KuruczKende/OmniPin/README.md

# OmniPin

## Description
This is a badge that can be customized while worn. The project contructs from a mobile application and a device.

### Technical Details
Microcontroller used: ESP32-C3-Mini-1
E-Paper: GDEM0154F51H
