KuruczKende/OmniPin/DeviceHardware/OmniPin/OmniPin.kicad_pcb

## KiCad design DeviceHardware/OmniPin/OmniPin.kicad_pcb (2026-01-04)

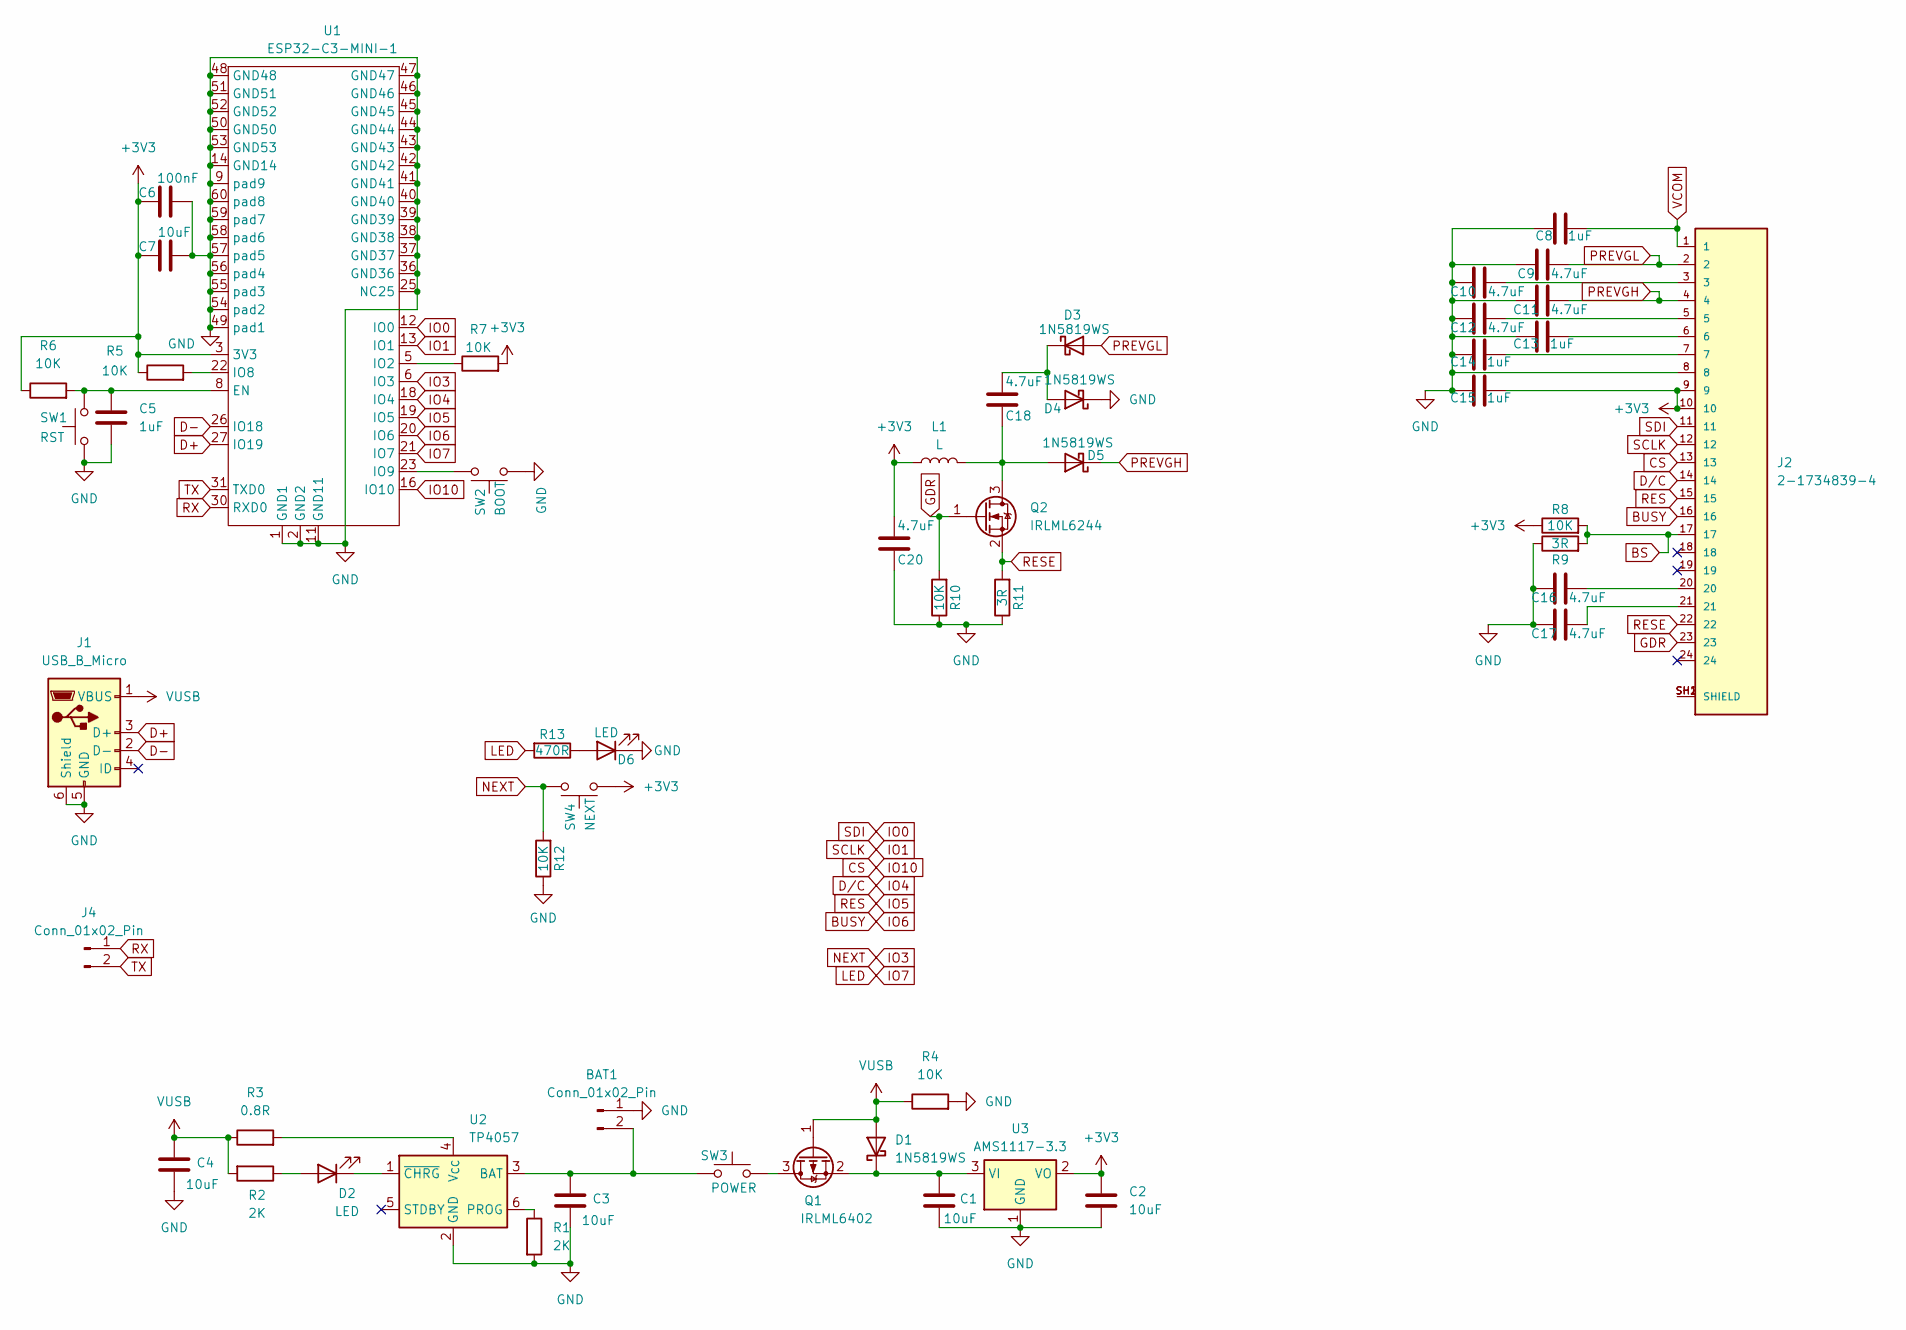
[picture p1: schematic OmniPin.kicad_sch, Omni Pin]

Parts:
BAT1: Conn_01x02_Pin; PinHeader_1x02_P1.27mm_Vertical
C1, C2, C3, C4, C7: 10uF; C_0603_1608Metric
C5, C8, C13, C14, C15: 1uF; C_0603_1608Metric
C6: 100nF; C_0603_1608Metric
C9, C10, C11, C12, C16, C17, C18, C20: 4.7uF; C_0603_1608Metric
D1, D3, D4, D5: 1N5819WS; D_SOD-323_HandSoldering
D2, D6: LED; LED_0603_1608Metric
J1: USB_B_Micro; USB_Micro-B_Amphenol_10118193-0002LF_Horizontal
J2: 2-1734839-4; TE_2-1734839-4; PARTREV 05-06
J4: Conn_01x02_Pin; PinHeader_1x02_P1.27mm_Vertical
L1: L; L_Taiyo-Yuden_NR-30xx_HandSoldering
Q1: IRLML6402; SOT-23
Q2: IRLML6244; SOT-23
R1, R2: 2K; R_0603_1608Metric
R3: 0.8R; R_0603_1608Metric
R4, R5, R6, R7, R8, R10, R12: 10K; R_0603_1608Metric
R9, R11: 3R; R_0603_1608Metric
R13: 470R; R_0603_1608Metric
SW1: RST; SW_SPST_B3U-3000P-B
SW2: BOOT; SolderJumper-2_P1.3mm_Open_RoundedPad1.0x1.5mm
SW3: POWER; PinHeader_1x02_P1.27mm_Vertical
SW4: NEXT; SW_SPST_B3U-3000P-B
U1: ESP32-C3-MINI-1
U2: TP4057; TSOT-23-6
U3: AMS1117-3.3; SOT-223-3_TabPin2

Connections:
+3V3: C2.1, C6.1, C7.1, C15.2, C20.1, J2.9, J2.10, L1.1, R5.1, R6.1, R7.2, R8.1, SW4.1, U1.3 (3V3), U3.2 (VO)
BS: J2.17, R8.2, R9.2
BUSY: J2.16, U1.20 (IO6)
CS: J2.13, U1.16 (IO10)
D+: J1.3 (D+), U1.27 (IO19)
D-: J1.2 (D-), U1.26 (IO18)
D/C: J2.14, U1.18 (IO4)
GDR: J2.23, Q2.1 (G), R10.2
GND: BAT1.1, C1.2, C2.2, C3.2, C4.2, C5.2, C6.2, C7.2, C8.1, C9.2, C10.2, C11.2, C12.2, C13.1, C14.1, C15.1, C16.2, C17.2, C20.2, D4.1 (K), D6.1 (K), J1.5 (GND), J1.6 (Shield), J2.8, R1.2, R4.2, R9.1, R10.1, R11.1, R12.1, SW1.1, SW2.1, U1.1 (GND1), U1.2 (GND2), U1.9 (pad9), U1.11 (GND11), U1.14 (GND14), U1.25 (NC25), U1.36 (GND36), U1.37 (GND37), U1.38 (GND38), U1.39 (GND39), U1.40 (GND40), U1.41 (GND41), U1.42 (GND42), U1.43 (GND43), U1.44 (GND44), U1.45 (GND45), U1.46 (GND46), U1.47 (GND47), U1.48 (GND48), U1.49 (pad1), U1.50 (GND50), U1.51 (GND51), U1.52 (GND52), U1.53 (GND53), U1.54 (pad2), U1.55 (pad3), U1.56 (pad4), U1.57 (pad5), U1.58 (pad6), U1.59 (pad7), U1.60 (pad8), U2.2 (GND), U3.1 (GND)
IO0: J2.11, U1.12 (IO0)
IO1: J2.12, U1.13 (IO1)
IO3: R12.2, SW4.2, U1.6 (IO3)
IO5: J2.15, U1.19 (IO5)
IO7: R13.2, U1.21 (IO7)
unnamed: BAT1.2, C3.1, SW3.1, U2.3 (BAT)
unnamed: C10.1, J2.3
unnamed: C12.1, J2.5
unnamed: C13.2, J2.6
unnamed: C14.2, J2.7
unnamed: C16.1, J2.20
unnamed: C17.1, J2.21
unnamed: C1.1, D1.1 (K), Q1.2 (S), U3.3 (VI)
unnamed: D2.2 (A), R2.1
unnamed: D2.1 (K), U2.1 (~CHRG)
unnamed: C18.1, D3.1 (K), D4.2 (A)
unnamed: C18.2, D5.2 (A), L1.2, Q2.3 (D)
unnamed: D6.2 (A), R13.1
unnamed: J2.SH1 (SHIELD), J2.SH2 (SHIELD)
unnamed: Q1.3 (D), SW3.2
unnamed: C5.1, R6.2, SW1.2, U1.8 (EN)
unnamed: R7.1, U1.5 (IO2)
unnamed: R5.2, U1.22 (IO8)
unnamed: SW2.2, U1.23 (IO9)
unnamed: R1.1, U2.6 (PROG)
unnamed: R3.2, U2.4 (V_{CC})
PREVGH: C11.1, D5.1 (K), J2.4
PREVGL: C9.1, D3.2 (A), J2.2
RESE: J2.22, Q2.2 (S), R11.2
RX: J4.1, U1.30 (RXD0)
TX: J4.2, U1.31 (TXD0)
VCOM: C8.2, J2.1
VUSB: C4.1, D1.2 (A), J1.1 (VBUS), Q1.1 (G), R2.2, R3.1, R4.1

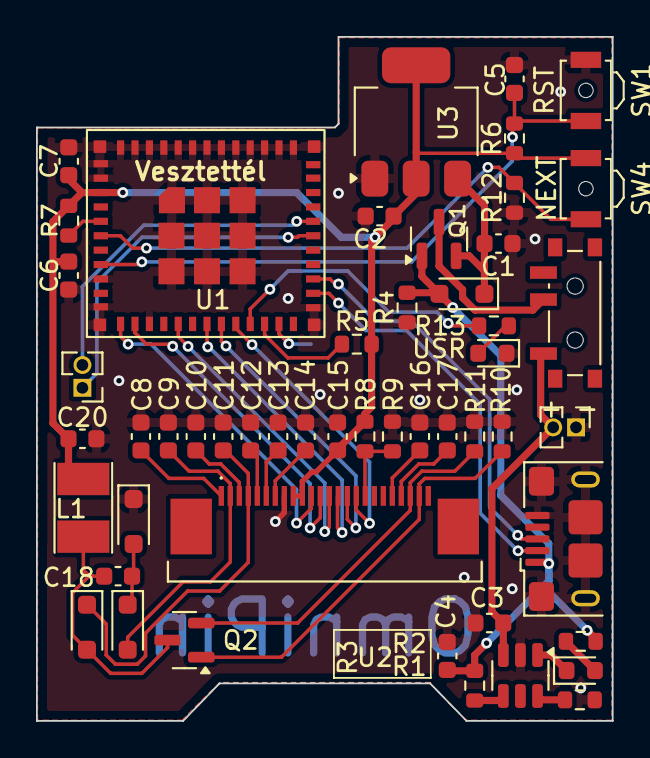
[picture p2: board OmniPin.kicad_pcb from above]

Board: 2 copper layers, 32.0 x 38.0 mm, 56 parts (1 on the bottom side), 42 nets.

Other parts of the board:
T1, T1#2, T1#3, T1#4: Tab
