KuruczKende/OmniPin/(commit log)

2025-07-07 adding the device(hw+sw) to the repo
    [OmniPin.kicad_pcb, OmniPin.kicad_sch]
2025-07-08 update pcb
    [OmniPin.kicad_pcb]
2025-10-02 hw panelization
    [OmniPin.kicad_pcb, OmniPin.kicad_sch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]
